thoreauA/Obstacle-Avoidance-CarLike-Robot-Arduino/example_sim.png

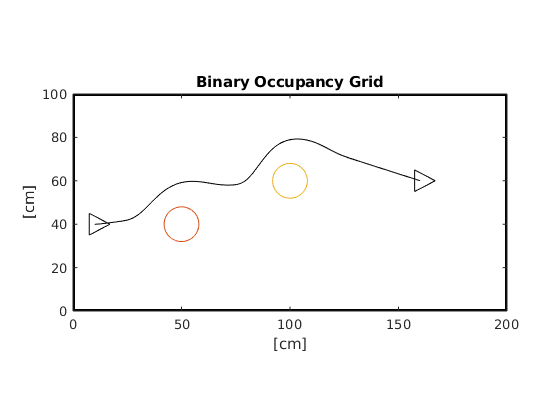
example_sim.png
